Halibut-Electronics/GX16-8P-Horizontal/README.md

# GX16-8P-Horizontal
A small board that allows the mounting of GX16-8P "8 pin round mic connectors" horizontally instead of vertically.
