Halibut-Electronics/GX16-8P-Horizontal/(threads)

Thread 1 (2023-05-25):

Replace 9-pin right angle .1" header with card edge

SmittyHalibut, 2023-05-25:
Retro-ticket for some work already done.

SmittyHalibut, 2023-05-25:
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

Given the above test boards, I've decided:
* Use the keyed slots, the "Offset" side, the one on the right where if its inserted backwards, the solder tabs won't line up.
* 1.6mm: Exact thickness is good.  Any thicker and it'll wobble too much.
* 0.96": But the routing of the tabs need a bit more slop in the long dimension, so adding 0.01" is good.
