Halibut-Electronics/GX16-8P-Horizontal/(commit log)

2022-12-06 Empty KiCAD project. Just setting up git.
    [GX16-8P-Horizontal.kicad_pcb, GX16-8P-Horizontal.kicad_sch]
2022-12-07 Shorter GX16-8P adapter board than my previous prototypes, trying to get the connector as close to the main board as possible. Still relies on a .1" right angle header for connecting to the main boar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
    [GX16-8P-Horizontal-CuBottom.gbr, GX16-8P-Horizontal-CuTop.gbr, GX16-8P-Horizontal-EdgeCuts.gbr, GX16-8P-Horizontal-MaskBottom.gbr, GX16-8P-Horizontal-MaskTop.gbr, GX16-8P-Horizontal-NPTH.drl, GX16-8P-Horizontal-PTH.drl, GX16-8P-Horizontal-PasteBottom.gbr]
2023-01-04 Updated the GX16 based on the drawing from the manufacturer. Brought pins in a bit. Wrote a python script to do the math to give me exact locations.
    [GX16-8P-Horizontal-CuBottom.gbr, GX16-8P-Horizontal-CuTop.gbr, GX16-8P-Horizontal-EdgeCuts.gbr, GX16-8P-Horizontal-MaskBottom.gbr, GX16-8P-Horizontal-MaskTop.gbr, GX16-8P-Horizontal-NPTH.drl, GX16-8P-Horizontal-PTH.drl, GX16-8P-Horizontal-PasteBottom.gbr]
2023-05-25 Moving to a sub directory to make space for another board design.
    [GX16-8P-Horizontal-CuBottom.gbr, GX16-8P-Horizontal-CuTop.gbr, GX16-8P-Horizontal-EdgeCuts.gbr, GX16-8P-Horizontal-MaskBottom.gbr, GX16-8P-Horizontal-MaskTop.gbr, GX16-8P-Horizontal-NPTH.drl, GX16-8P-Horizontal-PTH.drl, GX16-8P-Horizontal-PasteBottom.gbr]
2023-05-25 https://github.com/Halibut-Electronics/GX16-8P-Horizontal/issues/1 Test board for slot lengths and thicknesses
    [GX16-8P-Horizontal Slot Test-CuBottom.gbr, GX16-8P-Horizontal Slot Test-CuTop.gbr, GX16-8P-Horizontal Slot Test-EdgeCuts.gbr, GX16-8P-Horizontal Slot Test-MaskBottom.gbr, GX16-8P-Horizontal Slot Test-MaskTop.gbr, GX16-8P-Horizontal Slot Test-NPTH.drl, GX16-8P-Horizontal Slot Test-PTH.drl, GX16-8P-Horizontal Slot Test-PasteBottom.gbr]
2023-05-26 https://github.com/Halibut-Electronics/HHI-Radio-Pro/issues/34 Switched from pins to card edge.
    [GX16-8P-Horizontal Slot Test.kicad_pcb, GX16-8P-Horizontal Slot Test.kicad_sch, GX16-8P-Horizontal.kicad_pcb, GX16-8P-Horizontal.kicad_sch]
2023-06-03 https://github.com/Halibut-Electronics/HHI-User-Pro/issues/18 flip key to Pin9
    [GX16-8P-Horizontal.kicad_pcb]
2023-06-07 https://github.com/Halibut-Electronics/HHI-Radio-Pro/issues/43 Castelated the bottom edge to make soldering from the bottom easier.
    [GX16-8P-Horizontal-CuBottom.gbr, GX16-8P-Horizontal-CuTop.gbr, GX16-8P-Horizontal-EdgeCuts.gbr, GX16-8P-Horizontal-MaskBottom.gbr, GX16-8P-Horizontal-MaskTop.gbr, GX16-8P-Horizontal-NPTH.drl, GX16-8P-Horizontal-PTH.drl, GX16-8P-Horizontal-PasteBottom.gbr]
2023-06-23 https://github.com/Halibut-Electronics/HHI-Radio-Pro/issues/42 As sent to Synergetics
    [GX16-8P-Horizontal.kicad_pcb, GX16-8P-Horizontal.kicad_sch]
2024-09-25 KiCAD 8
